cyryljohn/DualWheeledCane/README.md

# DualWheeledCane
This is a design project
