cyryljohn/DualWheeledCane/Object Files/FinaleConnector.stl

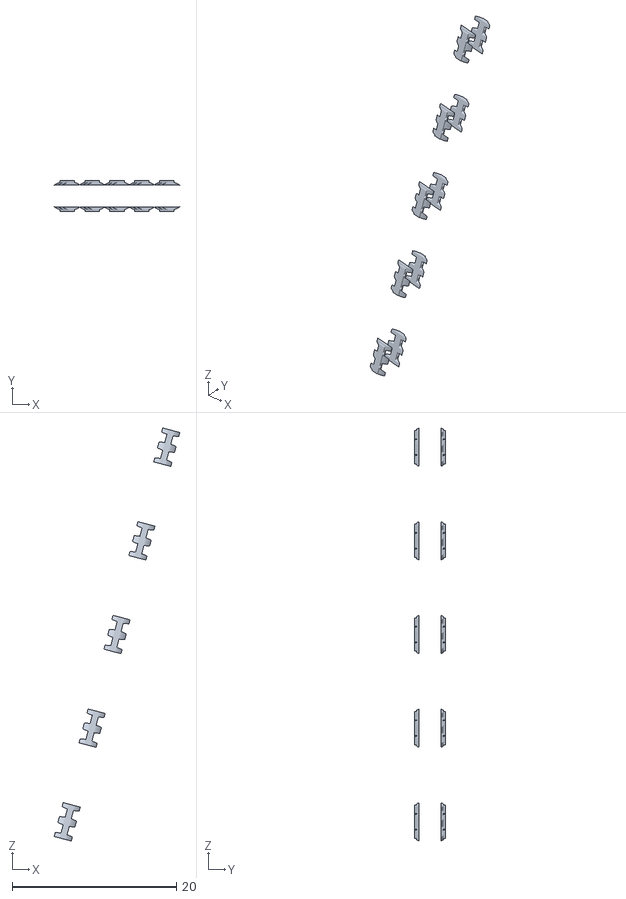
[picture p33: CAD file, 2020-09-16]
Object Files/FinaleConnector.stl
15.3 x 3.76 x 50.3
