cyryljohn/DualWheeledCane/Object Files/FinalePIR_a.stl

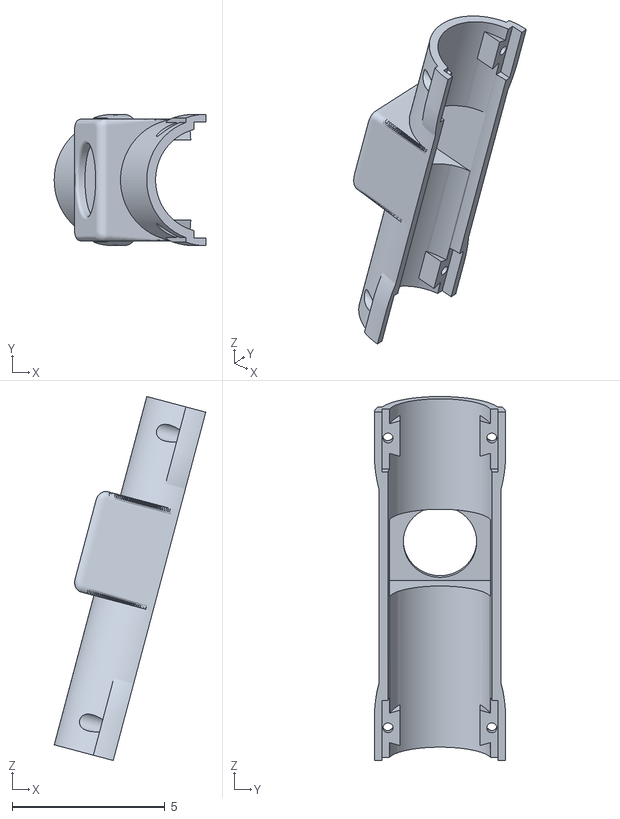
[picture p34: CAD file, 2020-09-16]
Object Files/FinalePIR_a.stl
4.96 x 4.30 x 11.9
