cyryljohn/DualWheeledCane/Object Files/FinaleBotBase.stl

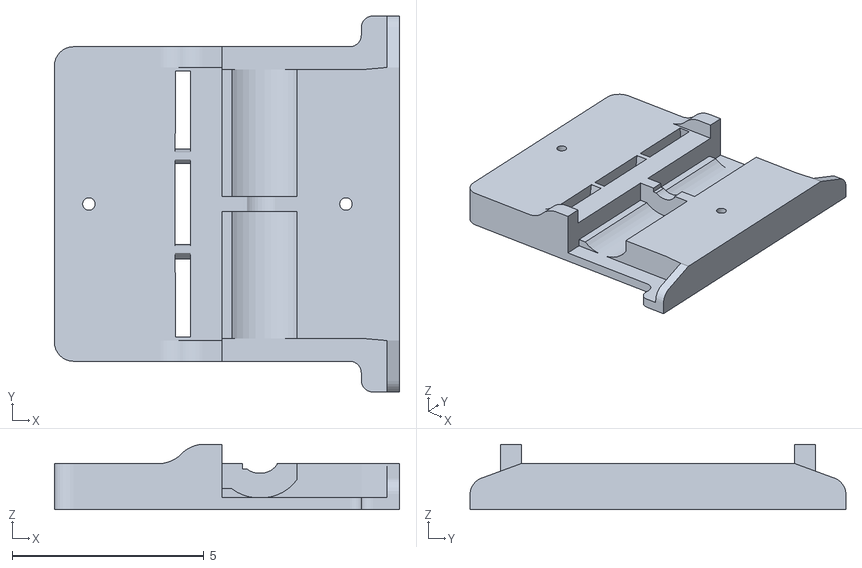
[picture p35: CAD file, 2020-09-16]
Object Files/FinaleBotBase.stl
9.00 x 9.80 x 1.70
