cyryljohn/DualWheeledCane/Object Files/FinaleBotUS_b.stl

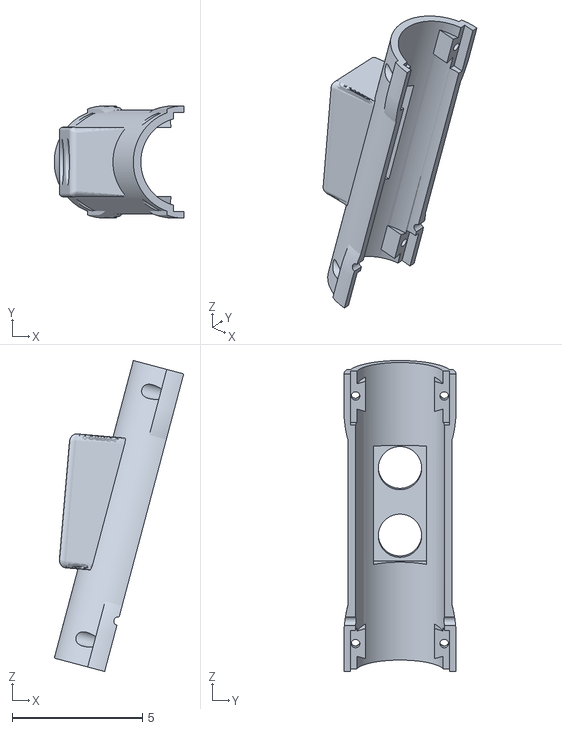
[picture p36: CAD file, 2020-09-16]
Object Files/FinaleBotUS_b.stl
4.96 x 4.30 x 11.9
