cyryljohn/DualWheeledCane/Object Files/FinaleTCS34725.stl

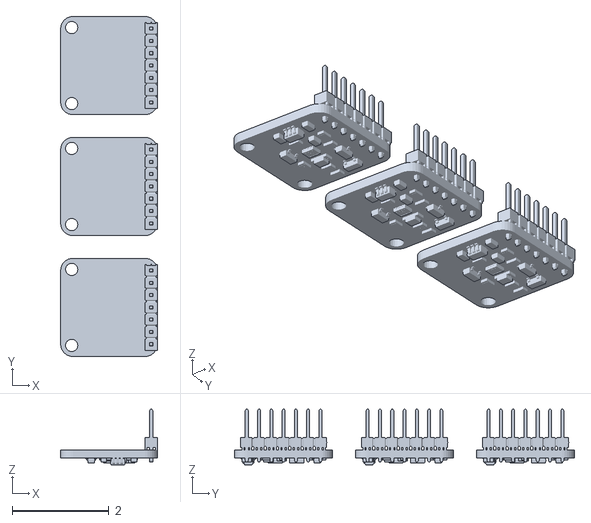
[picture p37: CAD file, 2020-09-16]
Object Files/FinaleTCS34725.stl
2.00 x 7.03 x 1.15
