cyryljohn/DualWheeledCane/Object Files/FinaleDerby.stl

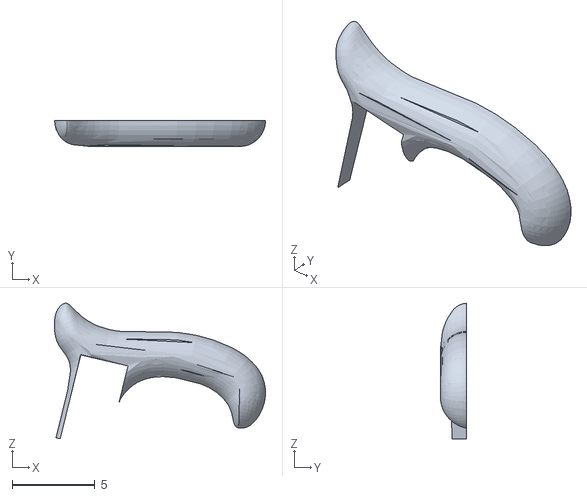
[picture p38: CAD file, 2020-09-16]
Object Files/FinaleDerby.stl
12.8 x 1.59 x 8.22
