cyryljohn/DualWheeledCane/Object Files/FinalePCB.stl

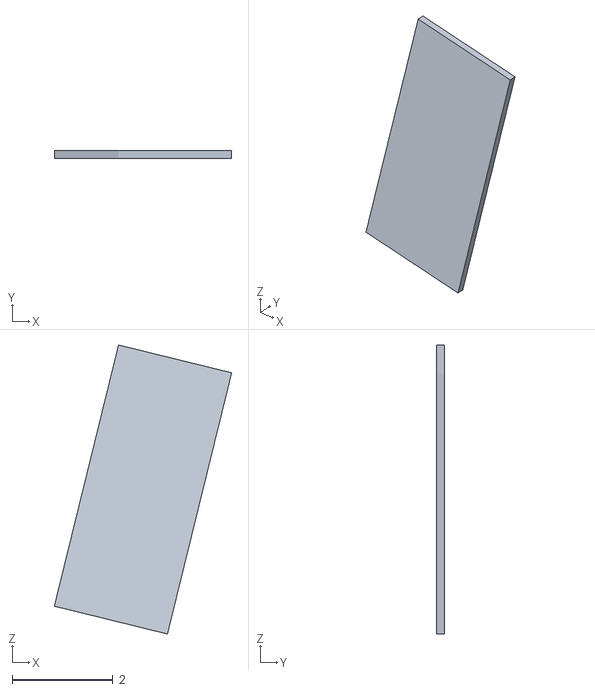
[picture p39: CAD file, 2020-09-16]
Object Files/FinalePCB.stl
3.52 x 0.15 x 5.73
