cyryljohn/DualWheeledCane/Object Files/FinaleTube3_1-Hole_003.stl

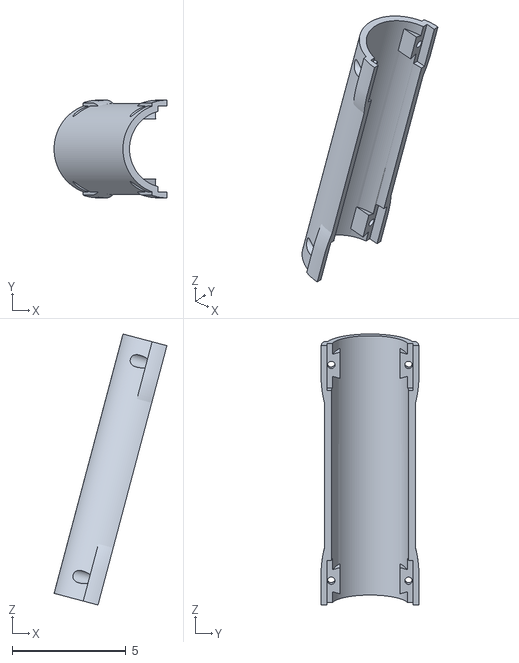
[picture p40: CAD file, 2020-09-16]
Object Files/FinaleTube3_1-Hole_003.stl
4.96 x 4.30 x 11.9
