cyryljohn/DualWheeledCane/Object Files/FinaleCover.stl

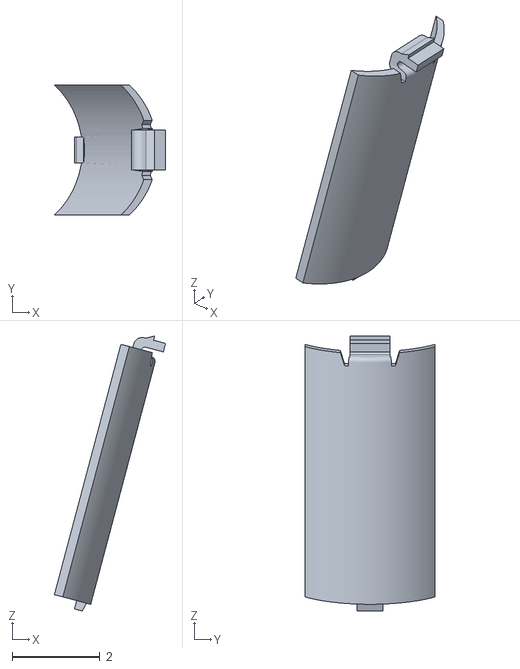
[picture p41: CAD file, 2020-09-16]
Object Files/FinaleCover.stl
2.53 x 2.96 x 6.26
