cyryljohn/DualWheeledCane/Object Files/Finale1.stl

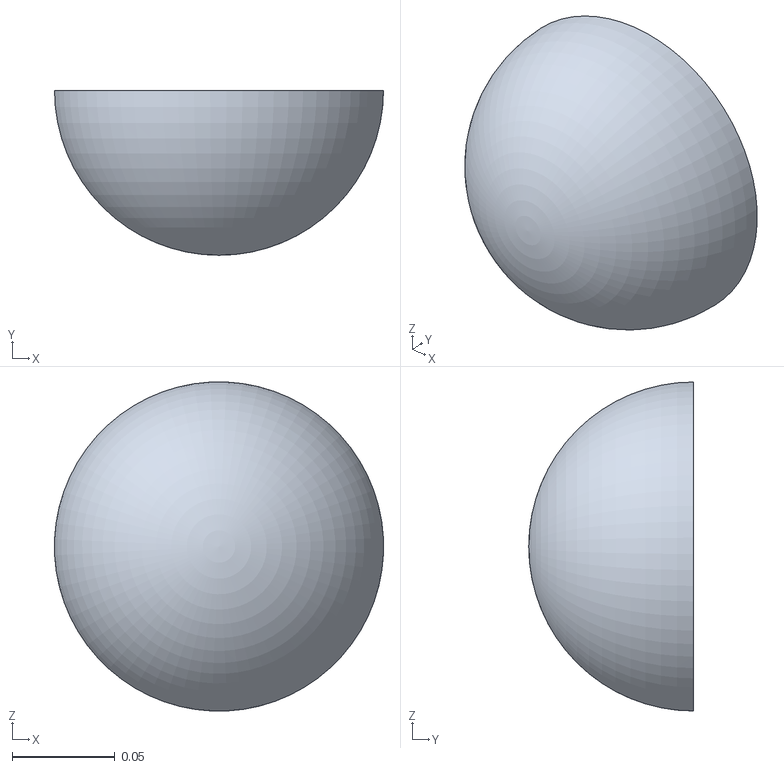
[picture p42: CAD file, 2020-09-16]
Object Files/Finale1.stl
0.16 x 0.08 x 0.16
