cyryljohn/DualWheeledCane/Object Files/FinaleTopBase.stl

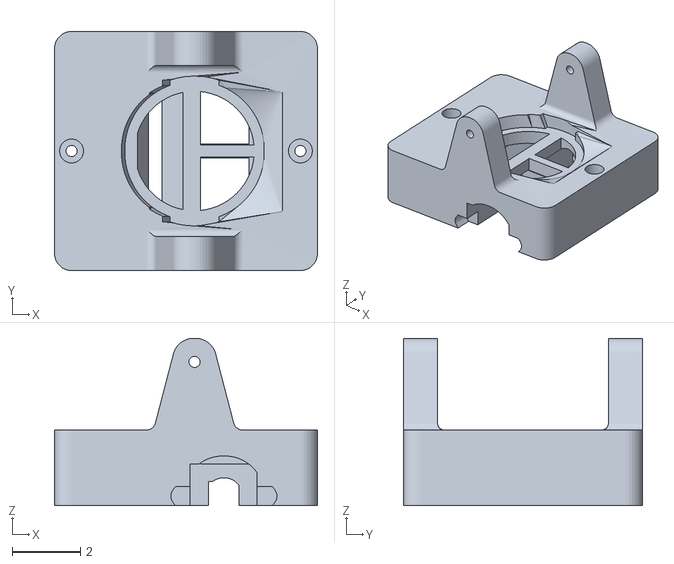
[picture p43: CAD file, 2020-09-16]
Object Files/FinaleTopBase.stl
7.70 x 7.00 x 4.90
