cyryljohn/DualWheeledCane/Object Files/FinaleLower.stl

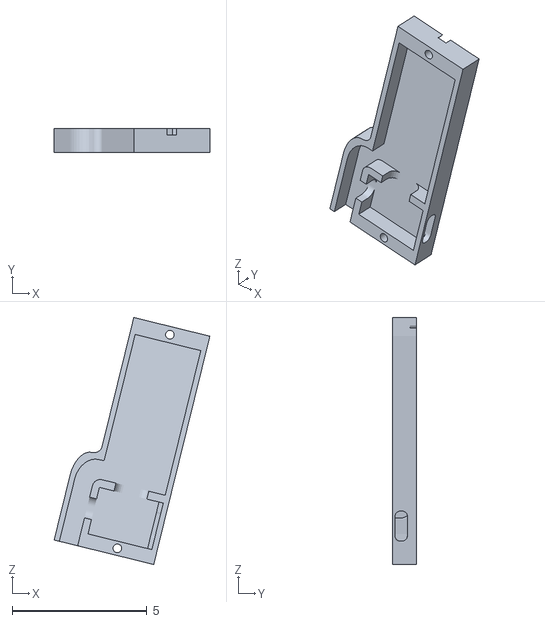
[picture p44: CAD file, 2020-09-16]
Object Files/FinaleLower.stl
5.79 x 0.9 x 9.18
