cyryljohn/DualWheeledCane/Object Files/FinaleDerby_001.stl

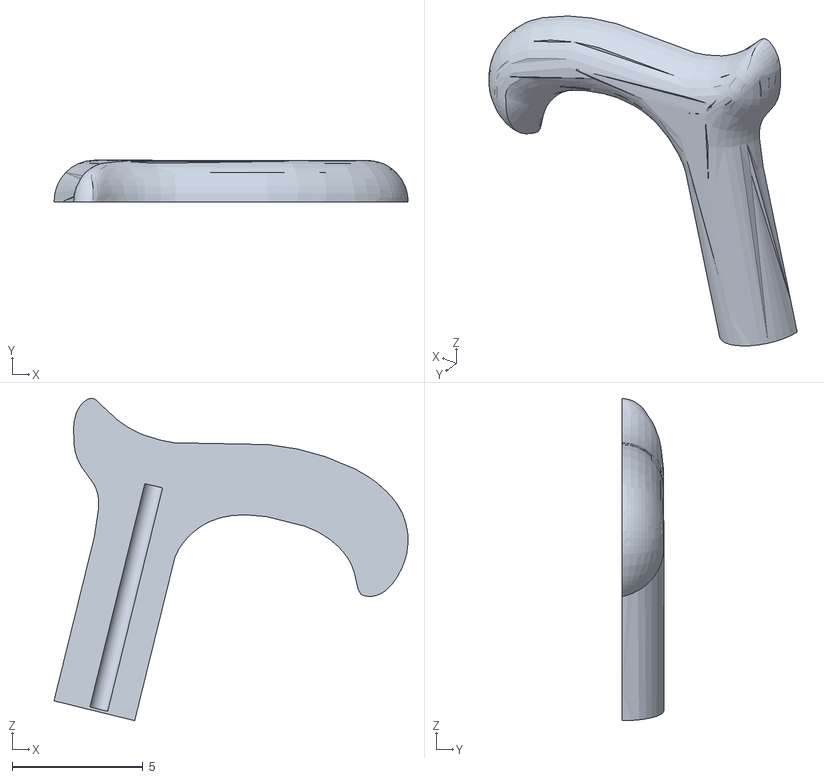
[picture p45: CAD file, 2020-09-16]
Object Files/FinaleDerby_001.stl
13.5 x 1.59 x 12.3
