cyryljohn/DualWheeledCane/Object Files/Finale4.stl

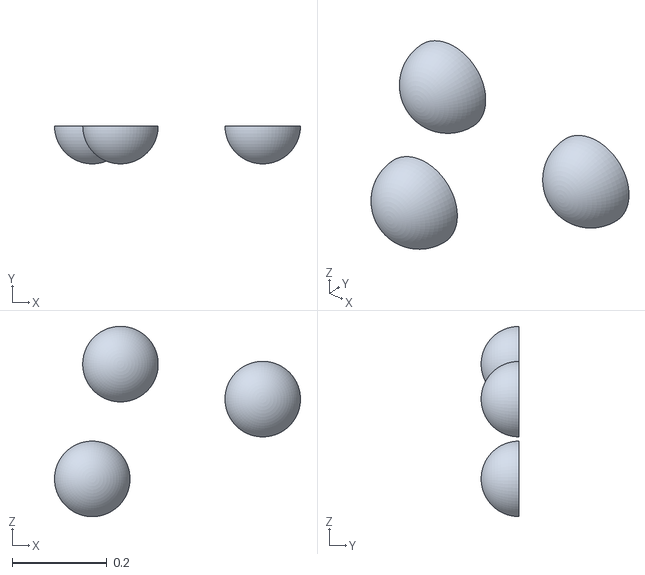
[picture p46: CAD file, 2020-09-16]
Object Files/Finale4.stl
0.521 x 0.08 x 0.403
