cyryljohn/DualWheeledCane/Object Files/FinaleMotor.stl

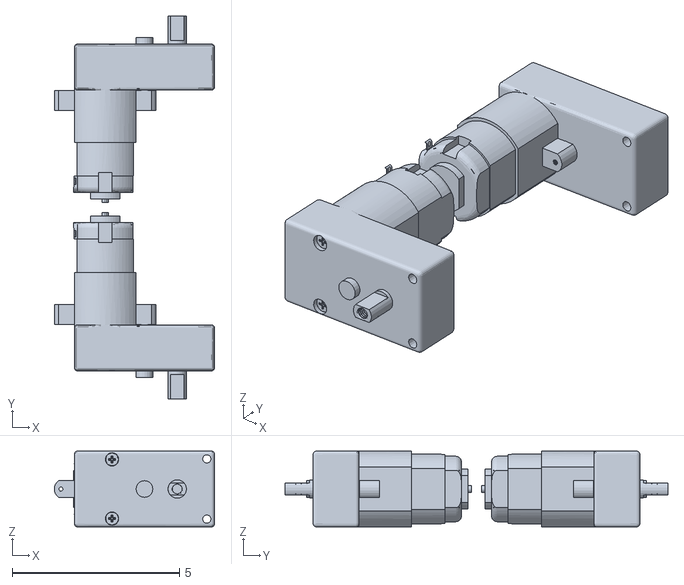
[picture p47: CAD file, 2020-09-16]
Object Files/FinaleMotor.stl
4.80 x 11.5 x 2.27
