cyryljohn/DualWheeledCane/Object Files/FinaleButCovtest.stl

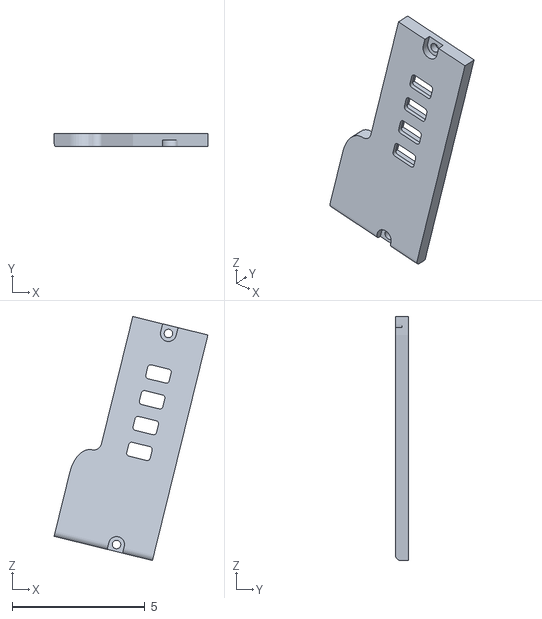
[picture p48: CAD file, 2020-09-16]
Object Files/FinaleButCovtest.stl
5.79 x 0.5 x 9.18
