cyryljohn/DualWheeledCane/Object Files/Finale2.stl

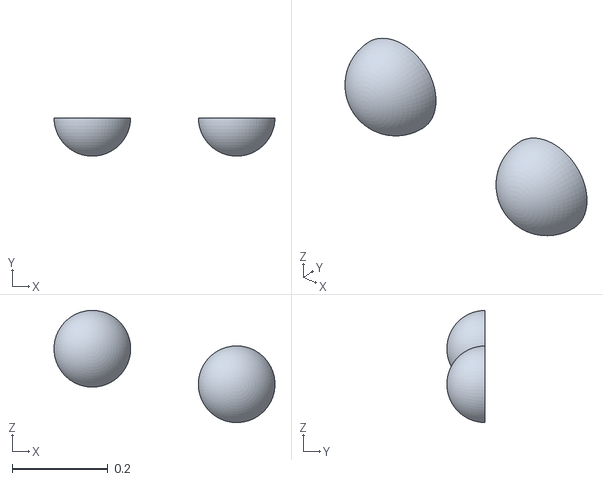
[picture p49: CAD file, 2020-09-16]
Object Files/Finale2.stl
0.461 x 0.08 x 0.234
