cyryljohn/DualWheeledCane/Object Files/Finale3.stl

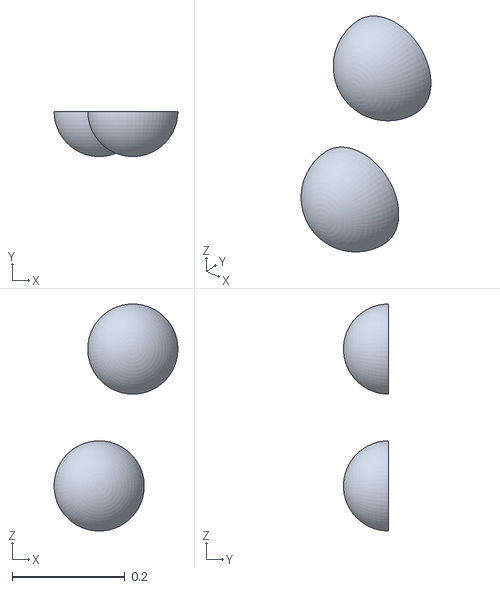
[picture p50: CAD file, 2020-09-16]
Object Files/Finale3.stl
0.22 x 0.08 x 0.403
