cyryljohn/DualWheeledCane/Object Files/FinaleButtons.stl

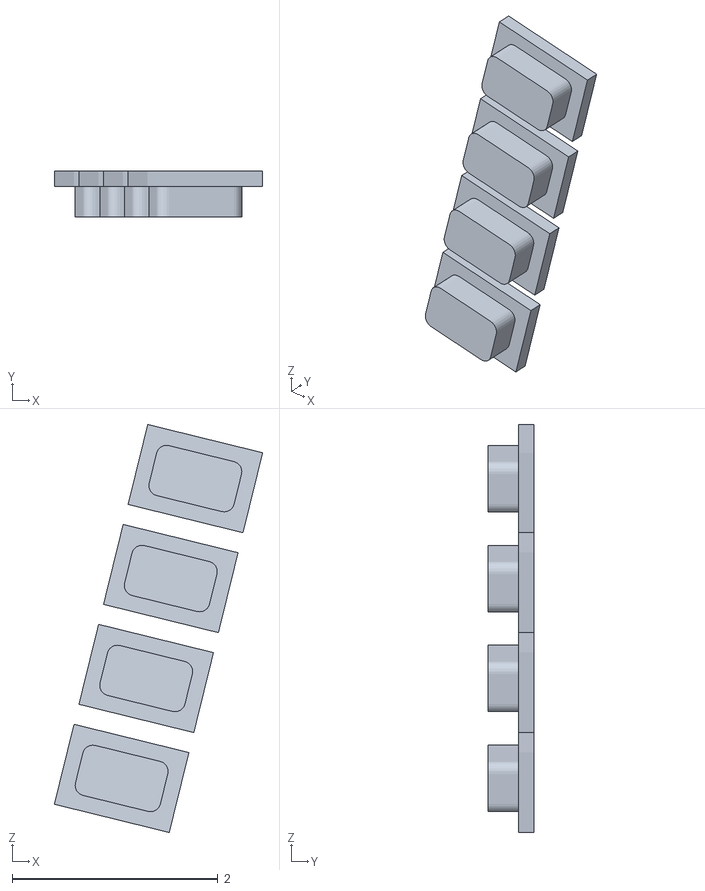
[picture p51: CAD file, 2020-09-16]
Object Files/FinaleButtons.stl
2.02 x 0.45 x 3.96
