cyryljohn/DualWheeledCane/Object Files/FinaleTP4056.stl

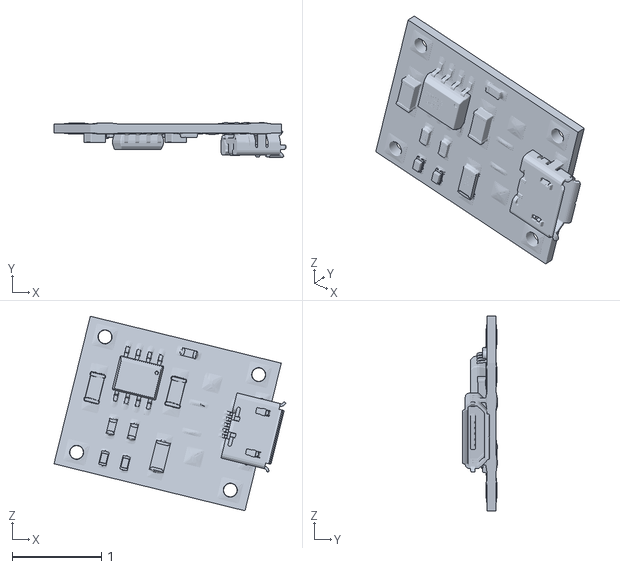
[picture p52: CAD file, 2020-09-16]
Object Files/FinaleTP4056.stl
2.59 x 0.388 x 2.18
