cyryljohn/DualWheeledCane/(list of files, cad)

Other CAD files:
Object Files/FinaleTube3_1-Hole_001.stl
Object Files/FinaleBotUS_a.stl
Object Files/FinaleTube3_1-Hole.stl
Object Files/FinalePIR_b.stl
Object Files/FinaleTube3_1-Hole_002.stl
Object Files/FinaleTube3_1-Hole_004.stl
Object Files/FinaleTube3_2-Nut.stl
Object Files/FinaleTube3_2-Nut_001.stl
Object Files/FinaleTube3_2-Nut_002.stl
Object Files/FinaleTube3_2-Nut_003.stl
Object Files/FinaleTube3_2-Nut_004.stl
