cyryljohn/DualWheeledCane/Schematic-and-PCB/GERBER-FILES/ATMEGA328P/How-to-order-PCB.txt

How to Order PCB

Please refer to:
https://docs.easyeda.com/en/PCB/Order-PCB
