cyryljohn/DualWheeledCane/Schematic-and-PCB/PCB-GUIDE.docx

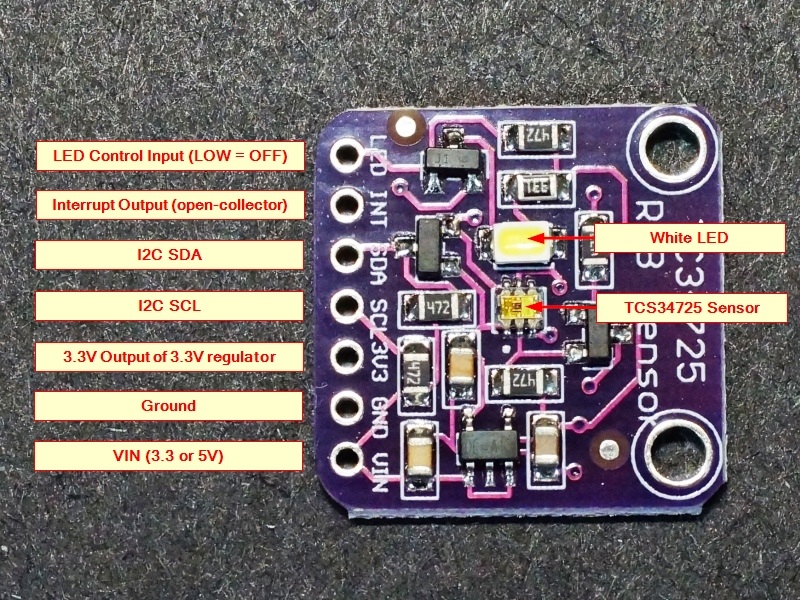
[picture p53: figure]
TCS34725 RGB Color Sensor Module - ProtoSupplies
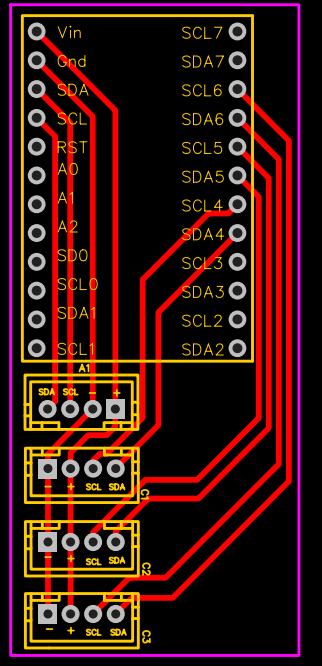
[picture p54: figure]

COLOR SENSOR

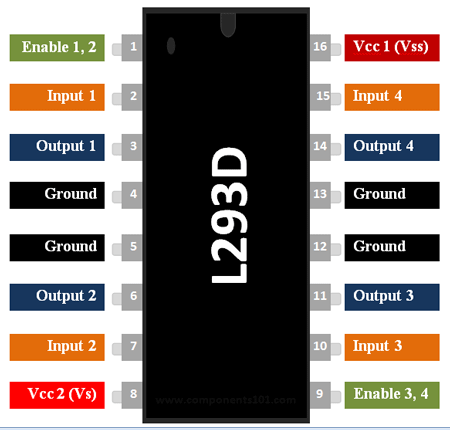
[picture p55: figure]
L293D Motor Driver IC Pinout, Equivalent ICs, Features and Datasheet
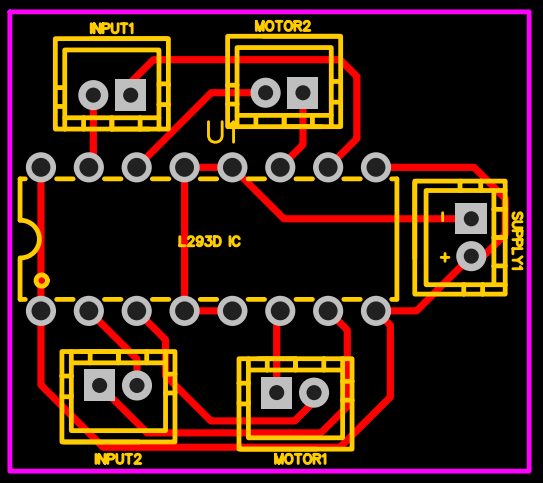
[picture p56: figure]

DC MOTOR

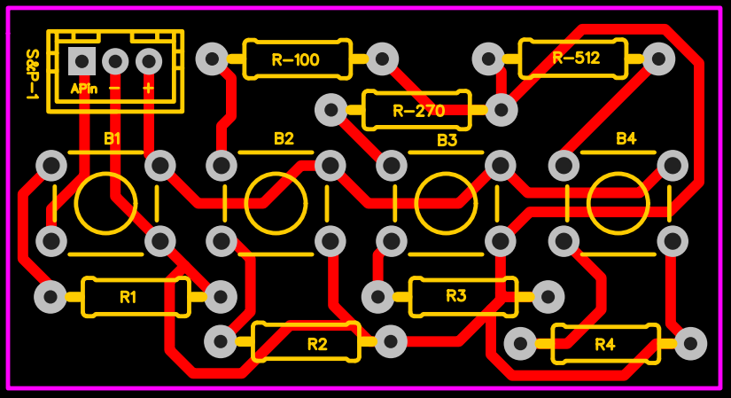
[picture p57: figure]

BRAILLE BUTTON CONTROL

DFPlayer_Mini_SKU_DFR0299-DFRobot
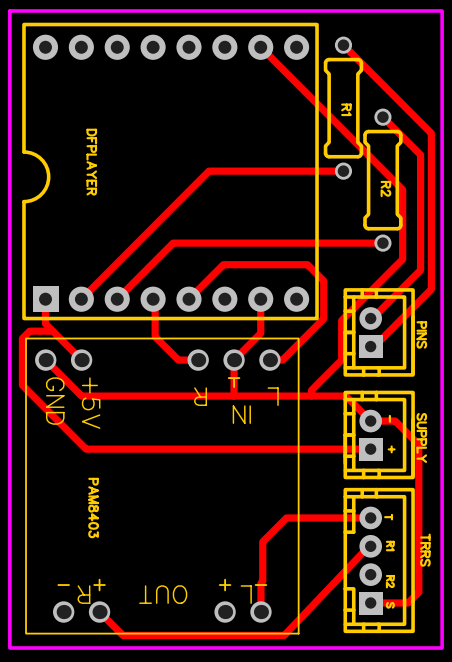
[picture p59: figure]

AUDIO CIRCUIT

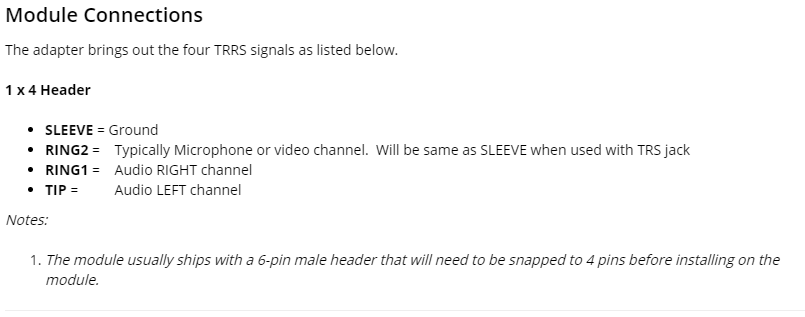
[picture p60: figure]
