cyryljohn/DualWheeledCane/Schematic-and-PCB/ATMEGA328P-GUIDE.pdf

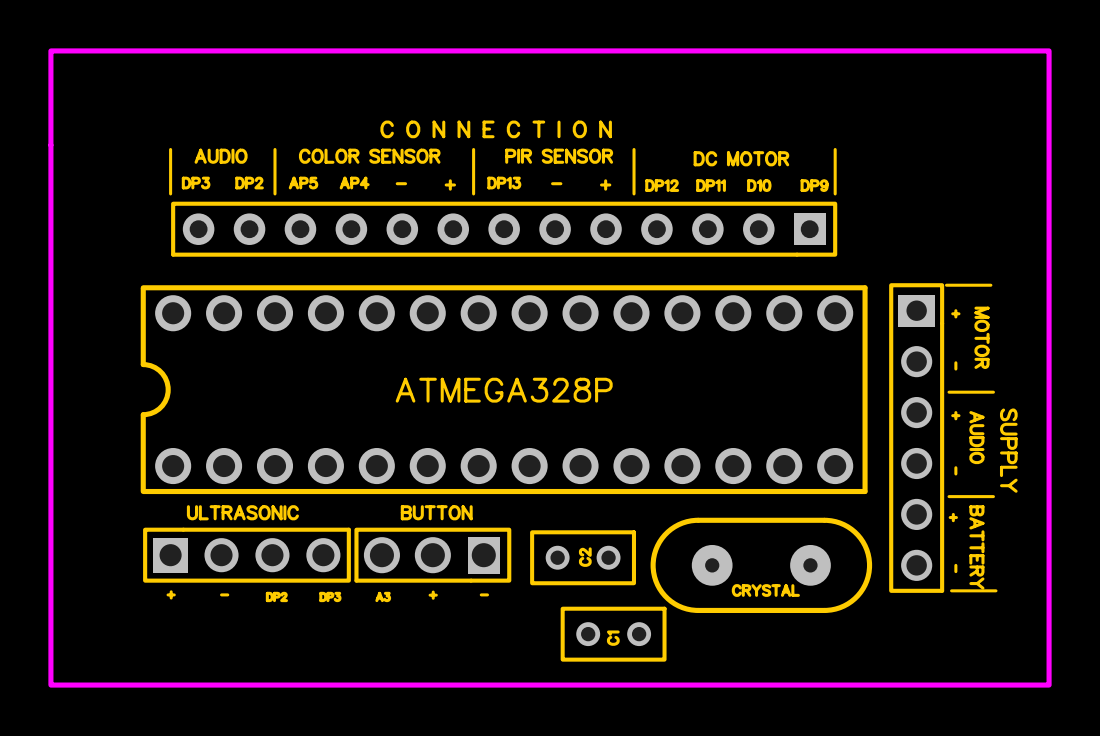
[picture p61: page 1]
