cyryljohn/DualWheeledCane/Schematic-and-PCB/Audio-Circuit.pdf

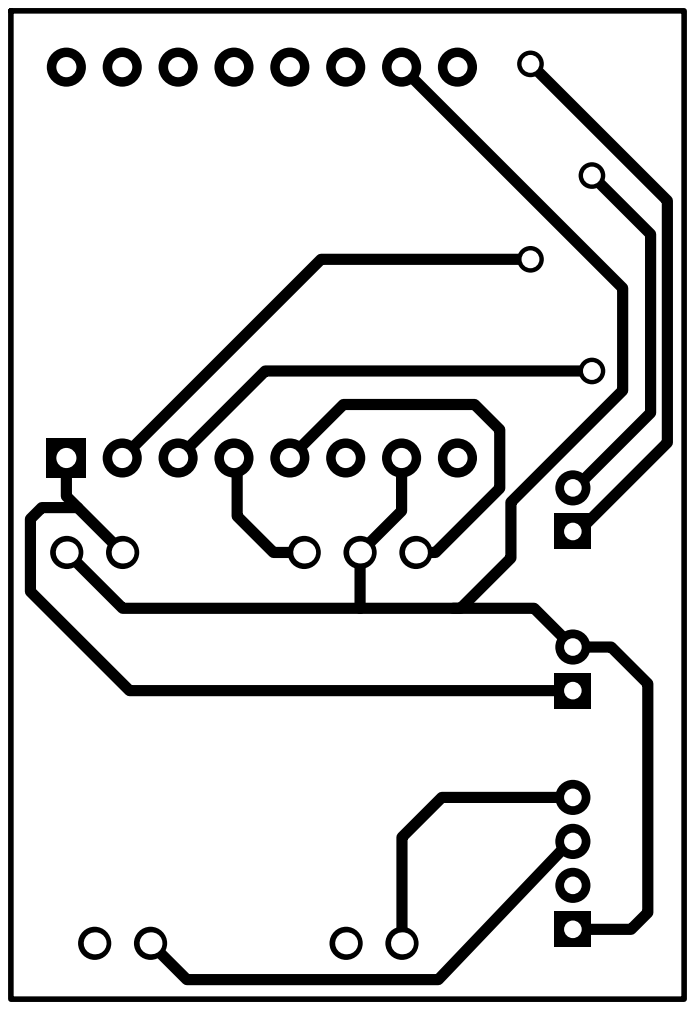
[picture p62: page 1]
