cyryljohn/DualWheeledCane/Schematic-and-PCB/Braille-Button-Control.pdf

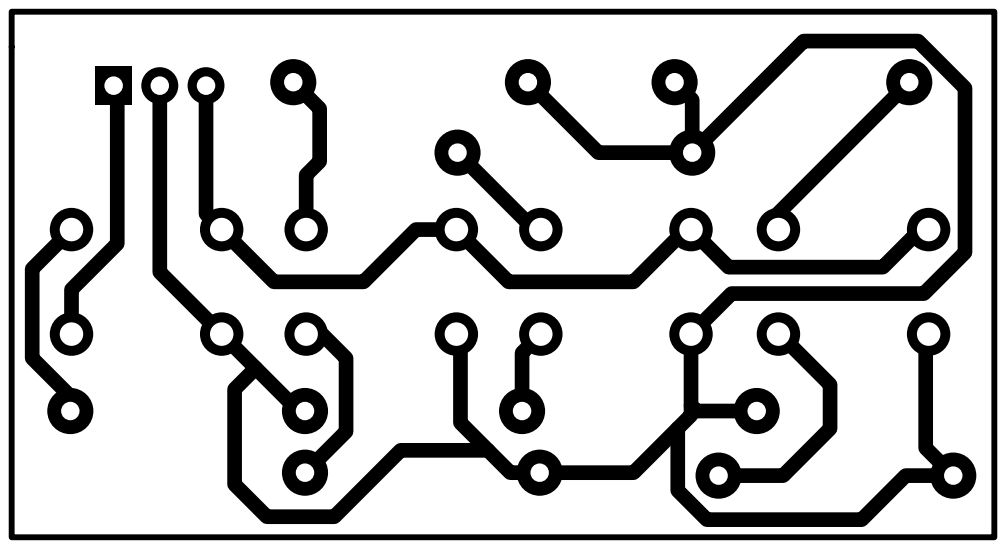
[picture p63: page 1]
