cyryljohn/DualWheeledCane/Schematic-and-PCB/Color-Sensor.pdf

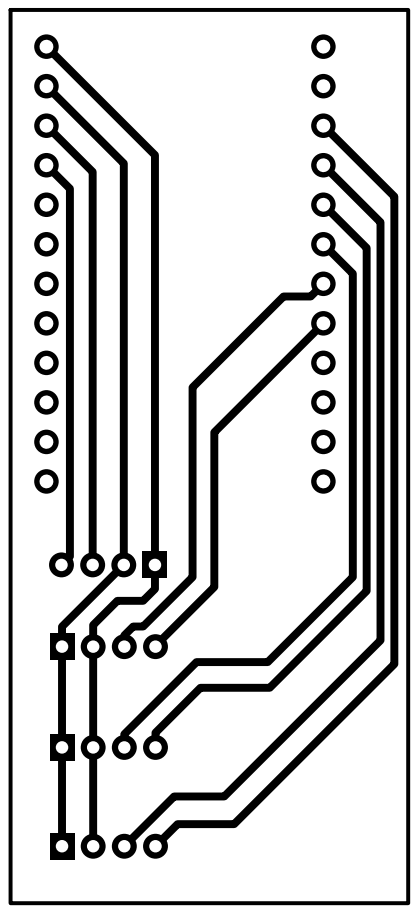
[picture p64: page 1]
