cyryljohn/DualWheeledCane/Schematic-and-PCB/DC-Motor.pdf

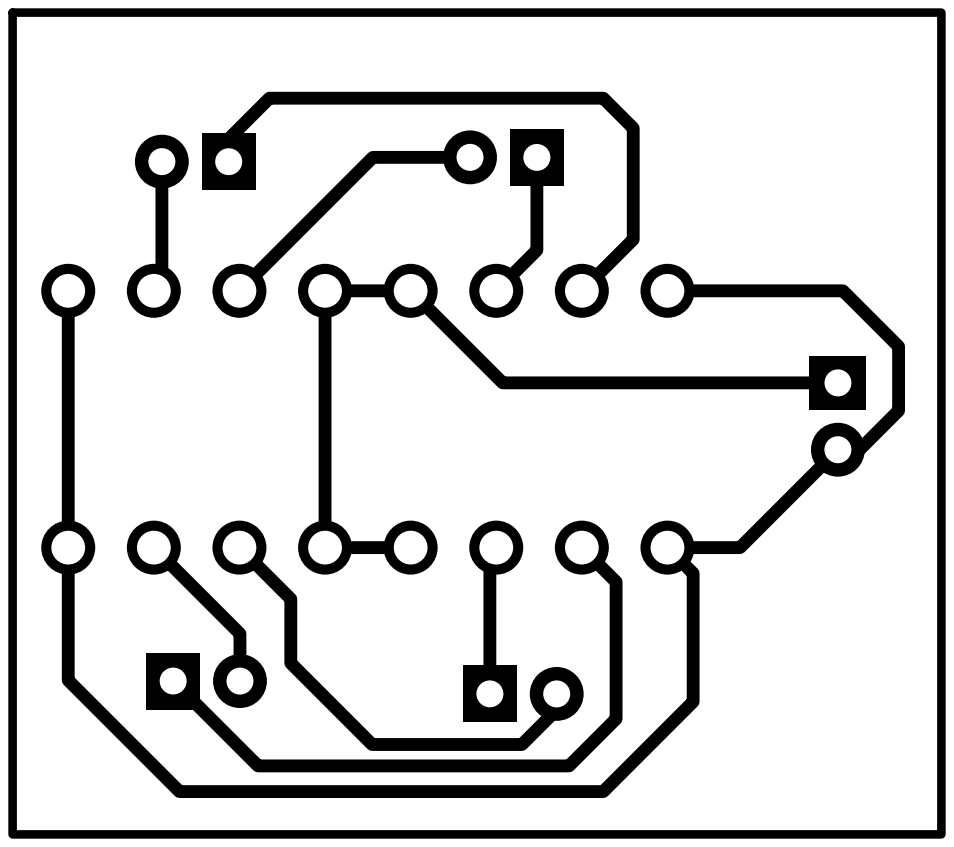
[picture p65: page 1]
