cyryljohn/DualWheeledCane/(commit log)

2020-09-16 Stl files are added
    [Finale1.stl, Finale2.stl, Finale3.stl, Finale4.stl, FinaleBotBase.stl, FinaleBotUS_a.stl, FinaleBotUS_b.stl, FinaleButCovtest.stl]
2020-10-06 Uploaded sample code for Motorized Cane
